Blevene/LabsConBadge_2023/(threads)

Thread 16 (2023-09-07):

file load/save

securelyfitz, 2023-09-07:
build a separate module to handle all file i/o. file i/o can be taken from prototype code, but data format needs to be simplified, perhaps raw text with 1 entry per line?
Data that needs to be stored and updated in files for persistence:

- contacts
- cards collected
- username/contact/handle
- settings?

read-only data that should come from files

- game's public key
- strings for all of the game cards
- sprite bmps in /assets

ideally the module will have a few member functions:

- init() will open files and load all data into in-memory structures
- save() will save the r/w files to flash
- reload() might be necessary to load just the r/w files?

there is some state that should be derived from the files and calculated on load:

-  current game # based on the highest game # with two cards
- ?

securelyfitz, 2023-09-24:
everything but crypto done, but there's a separate issue for that, so closing this one.

Note: *either* circuitpython *or* the usb host can write files - not both at the same time. See boot.py for more.

Closed 2023-09-24.

Thread 18 (2023-09-07):

contacts display

securelyfitz, 2023-09-07:
contacts will be loaded from a file at poweron, added every time a card is traded, and updated in flash before sleeping as implemented in #15.

Simplest option would be a file full of single line strings that are the saved names.

Optionally, store the card # that was received from that person, but this is a nice-to-have and could be broken off into a different task for completion later

This list should be displayed on the 'contacts' page, which has room for 3 lines of text. up and down buttons should cycle through the list. The 'selected' contact can be highlighted. bolded, have a carrot indicator, or just be indented differently. 'x' should pop up the detail display with the full contact name and possibly the card(s) received from them.

when cycling to the bottom of the list, perhaps put a 'return to top' indicator after the last item. Pressing down again should jump to the top of the list, not go to sleep.

securelyfitz, 2023-09-24:
feature complete; adding alibi-to-clue linkage to future improvements in #29

Closed 2023-09-24.

Thread 22 (2023-09-07):

fine tune trade process

securelyfitz, 2023-09-07:
right now it mostly works but has a few software delays hard coded for ease of debugging.

probably makes sense to break out 'transmit' and 'receive' into class member functions to make the trade logic a bit cleaner

also - once a trade happens, the card needs to be validated and both the card and handle need to be stored properly

securelyfitz, 2023-09-21:
overlay and text cleaned up. annoying hard crash issue disappeared for small transactions, but is now blocking TX/RX. some details:

- ONLY happens with RX
- ONLY happens when RX receives some data - if nothing recieved, no crash
- Happens WHETHER OR NOT valid details recieved, but ALWAYS happens when valid details recieved
- Example: go to RX mode, point camera with IR rangefinder at badge - no valid chars received, but crash happens
- things still work UNTIL leaving the trade screen - shifing back to the previous screen
- doesn't matter what screen you shift back to
- crash happens on different lines of code at different times
- it's incredibly hard to debug because it's a hard python interpreter crash that kills the usb-serial
- only way back to functioning is full power cycle
- there's an irda phy that can have power enabled/disabled
- tx data is echoed back by the phy, so uart rx is flushed after EVERY SINGLE byte sent
- TX works fine, commenting out just the RX line clears the issue completely

theory:
- RP2040 hardware uart is recieving properly
- circuitpython reads the data and buffers it
- circuitpython has a memory issue where if's overfilling a buffer or something, corrupting other memory.

securelyfitz, 2023-09-21:
More notes:
- i've isolated a minimum case of the failure. By instantiating fakeirda and immediately powering on the badge, then sending data, it will immediately hard crash (circuitpython crash to recovery mode)
- I've tried slowing down the transmission which didn't seem to have any improvment
- i'm trying transmissions starting at 1 byte at a time and incrementing my way up. Considering the doubling of bytes that happens:
 - Up to 18 bytes works fine. 20 bytes fails.
 - sometimes 20 bytes results in a nonsensical error in dpad.py
 - more than 20 always results in hard crash

securelyfitz, 2023-09-24:
workaround is to use busio to create the UART interface with a large buffer.
Have not isolated the missing bounds checking.

Solved two issues with TX/RX sync with a lead-in of carriage returns:
1. the first few bytes sent after power is enabled to the IRDA phy seem to be error prone. A lead-in of CR's gets some run time before transmitting the data. Received CR's are then trimmed as whitespace.
2. sometimes, the 2-byte symbols are misaligned. To fix, the fake_ira.readbyte member checks every byte coming in - if twice in a row, it receives a misaligned CR's, it reads and drops one more byte so that it's back in sync

With this, the majority of transmissions are flawless. There are still occasional bitflips, but crc/encryption should easily catch those.

Closing this for the badge - but will pursue the memory corruption issue elsewhere.

Closed 2023-09-24.

Thread 24 (2023-09-07):

implement neopixel patterns

securelyfitz, 2023-09-07:
likely plenty of open source examples to choose from. Should probably include at least:
- rainbow cycle across leds
- rainbow cycle, all leds in sync- chaser/marquee
- heartbeat
- fire
- flashlight

these patterns should be contained in a separate .py file with comments to tell end users how to modify them
The current pattern should be selectable from the settings menu.

psifertex, 2023-09-21:
I noticed the gc was interrupting the animation (I know it'll go away once done but for now just re-ordering it smooths out animations) and I also split up the animation style and color into two settings.

securelyfitz, 2023-09-21:
awesome - i added excessive gc in an unsuccesful attempt to resolve the RX issue which at first i though was running out of memory, but now i think is memory corruption related.

psifertex, 2023-09-21:
Added brightness setting, cleaned up the sparkle pattern which wasn't really working and added chase.

psifertex, 2023-09-21:
Probably can close this one out at this point, lights are pretty full featured.

securelyfitz, 2023-09-24:
thanks again. I moved gc to the gamedata class after a new clue is added, since that's where the most memory collection happens.

Closed 2023-09-24.
