Blevene/LabsConBadge_2023/(list of files, drawings)

Other design files:
prototype/diagram/ThroughHoleProtoType.fzz
