Blevene/LabsConBadge_2023/prototype/logic/1_button_IR_TX_RX.py

'''
Thanks ChatGPT.
This code allows us to transmit and recieve a message using IR
At the press of a button.
'''
import board
import pulseio
import digitalio
import time

# create pulsein and pulseout objects to read and write IR pulses
pulsein = pulseio.PulseIn(board.D12, maxlen=120, idle_state=True)
pulseout = pulseio.PulseOut(board.D13)

# set up button
# one pin to D3, other to Ground
button = digitalio.DigitalInOut(board.D3)
button.direction = digitalio.Direction.INPUT
button.pull = digitalio.Pull.UP

# set up LED
led = digitalio.DigitalInOut(board.D13)
led.direction = digitalio.Direction.OUTPUT

while True:
    # wait for button press
    while not button.value:
        pass

    # blink LED while sending and receiving data
    while True:
        led.value = True
        pulseout.send(b'Hello')
        led.value = False
        time.sleep(0.2)  # blink LED every 200ms

        # read incoming message
        pulses = pulsein.read(10)  # read up to 10 pulses

        if pulses:  # if a message was received
            # decode message
            message = pulseio.decode_bits_to_bytes(pulses)
            print(message)
            break  # exit inner loop
