Blevene/LabsConBadge_2023/software/sleep.py

from sh1106_ui import sh1106ui

#this class manages the sleep mode. Right now it just blanks the screen, 
#but it should power down the display driver, power down the IRDA, and 
#power down the WS2182b's
class sleep:
    def __init__(self, display, dpad):
        self.dpad=dpad
        self.display=display

    def update(self):
        #self.display.header.text="sleep"
        if self.dpad.x.fell:
            self.display.maingroup.hidden=False
            return 0 # will return to last normal page
        elif self.dpad.u.fell:
            self.display.maingroup.hidden=False
            return 0 # will return to last normal page
        self.display.maingroup.hidden=True
        return "sleep"
