Blevene/LabsConBadge_2023/(commit log)

2023-01-04 Initial Setup of Prototype stuff
    [ThroughHoleProtoType.fzz]
2023-08-03 Menu Prototype
    Display a Text Based menu that can be navigated with a 5 way switch.
2023-08-03 updated to include a "clues" submenu
    The clues submenu will trigger when show all clues is selects and middle clicked on the button.
2023-08-03 boiler plate wrappers
    Added some boiler plate logic for wrapping other menu functions.
2023-08-17 Debounce and Boot
    Added debounce to menu_proto to account for button press speed. Also added a boot.py script which controls whether circuit python can write to the file system (Flash) of the onboard device.
2023-08-19 Main code for the board!
    Added code to push to the badges
2023-08-19 inital schematic, dpad symbolw
    [labsconbadge-23.kicad_pcb, labsconbadge-23.kicad_sch]
2023-08-19 schematic complete
    [labsconbadge-23.kicad_sch]
2023-08-19 most footprints added; rp2040 symbol, components optimized
    [labsconbadge-23.kicad_sch]
2023-08-19 general part layout and rp2040 capacitors in place
    [labsconbadge-23.kicad_pcb, labsconbadge-23.kicad_sch]
2023-08-19 starting to route traces
    [labsconbadge-23.kicad_pcb, labsconbadge-23.kicad_sch]
2023-08-19 pretty up schematic and other minor adjustments
    [labsconbadge-23.kicad_pcb, labsconbadge-23.kicad_sch]
2023-08-19 clean up schematic more; remove FB1 to disconnect vbus from vbatt
    [labsconbadge-23.kicad_pcb, labsconbadge-23.kicad_sch]
2023-08-19 added mugshot letterboard art on back
    [labsconbadge-23.kicad_pcb]
2023-08-19 minor tweaks plus gitignore changes for rebasing
    [labsconbadge-23.kicad_pcb, labsconbadge-23.kicad_sch]
2023-08-24 fixing project references to footprint wihtout * in filenamewq
    [labsconbadge-23.kicad_pcb, labsconbadge-23.kicad_sch]
2023-08-24 various DFM parameters set in component propertieswq
    [labsconbadge-23.kicad_pcb, labsconbadge-23.kicad_sch]
2023-08-24 adding symbol and footprint for tdu4101
2023-08-28 adding component changes, schematic changes based on issue #12
    [labsconbadge-23.kicad_pcb, labsconbadge-23.kicad_sch, ws2018b.kicad_sch]
2023-08-29 nearly all final changes made; ready to experiment with LED placement and badge size
    [labsconbadge-23.kicad_pcb, labsconbadge-23.kicad_sch]
2023-08-29 changes to bom for jlc production
    [labsconbadge-23.kicad_sch]
2023-08-30 cosmetic and routing changes to final board revisionwq
    [labsconbadge-23.kicad_pcb, labsconbadge-23.kicad_sch]
2023-08-30 All changes made, passing DRC, preparing for assembly
    [labsconbadge-23.kicad_pcb, labsconbadge-23.kicad_sch, ws2018b.kicad_sch]
2023-08-30 some bom details adjusted for assembly
    [labsconbadge-23.kicad_pcb, labsconbadge-23.kicad_sch]
2023-08-30 minor silkscreen label changes
    [labsconbadge-23.kicad_pcb]
2023-08-31 oops, git doesn't follow symlinks. hard copies here.
    [irrx.py, irtx.py]
2023-09-01 refactoring dpad control into a module containt a class that holds all 5 debounced buttons
2023-09-01 refactoring tx/rx into a module/class that wraps uart and does all the irda swizzle
2023-09-01 added duration() which returns the time since last action on any button
2023-09-04 clean up ui, add page transitions, other minor fixes
    [code.py]
2023-09-10 Update README.md
    adding some pointers to learn more about circuitpython, plus details about the game code object model
2023-09-17 hide contents while animating; remove home overlay and just switch content; file backed alibis
2023-09-18 clues loaded from CSV, enhanced clue display, started to tinker with trade but not working yet
    [clues.py, code.py, game.py, trade.py]
2023-09-18 debug an issue where it seems like rising edges are being missed. Lowering baud rate works well enough to fix it
    [irrx.py, irtx.py]
2023-09-18 adding sample game data plus sample alibi list
    [game1.csv]
2023-09-20 make user control phy enable/disable; keep buffer clear; cleanup print statements
2023-09-20 fix typos, implement some settings, clean up text displays
    [alibis.py, clues.py, code.py, game.py, settings.py, trade.py]
2023-09-20 add led patterns and settings
2023-09-20 file cleanup; name entry; led off setting
2023-09-20 fix rx string format; add neopixel
    [trade.py]
2023-09-20 updated trade to fix tx/rx issues
    [trade.py]
2023-09-20 debug rx delay; fix game advance
    [game.py, trade.py]
2023-09-20 fixing redeal when new game started
    [settings.py]
2023-09-20 fix local variable reference
    [game.py]
2023-09-20 initialize cluecounts for corner case
2023-09-20 adding game files
    [game0.csv, game1.csv, game2.csv, game3.csv, game4.csv, game5.csv, game6.csv, game7.csv]
2023-09-20 fixing strings and display
    [home.py]
2023-09-21 disable rx and not crashnburn
    [trade.py]
2023-09-21 breaking out LEDcontrol class to separate file
2023-09-21 fixing clue writeout and alibi writeout
    [clues.py]
2023-09-21 this actually has the file writeout. the previous commit has card view fixes
    [game.py]
2023-09-21 switch to busio
2023-09-22 forgot to add this file for led control class previousl
2023-09-22 streamlining game generation; removing game files from git, in part because it reveals the solution
    [0_game4.csv, 100_game0.csv, 100_game1.csv, 100_game2.csv, 100_game4.csv, 101_game0.csv, 101_game1.csv, 101_game2.csv]
2023-09-26 ignoring additional kicad production output files
2023-09-27 don't track generated game files
